KrisKasprzak/IrrigationGenie/AerialHouseView.png

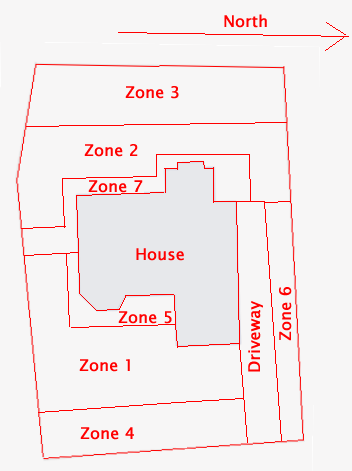
AerialHouseView.png
