KrisKasprzak/IrrigationGenie/docs/screenshots/tft-keyboard.png

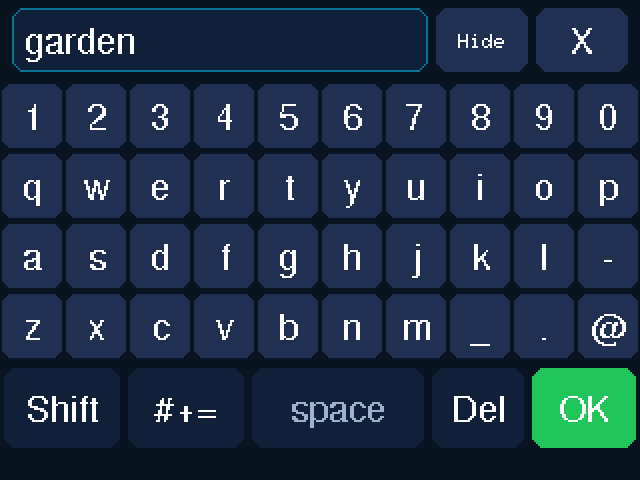
docs/screenshots/tft-keyboard.png
