KrisKasprzak/IrrigationGenie/docs/screenshots/tft-time-popup.png

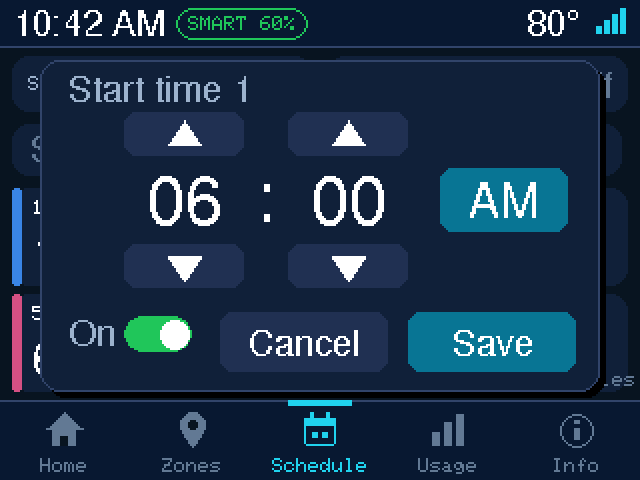
docs/screenshots/tft-time-popup.png
