KrisKasprzak/IrrigationGenie/docs/screenshots/tft-winter-popup.png

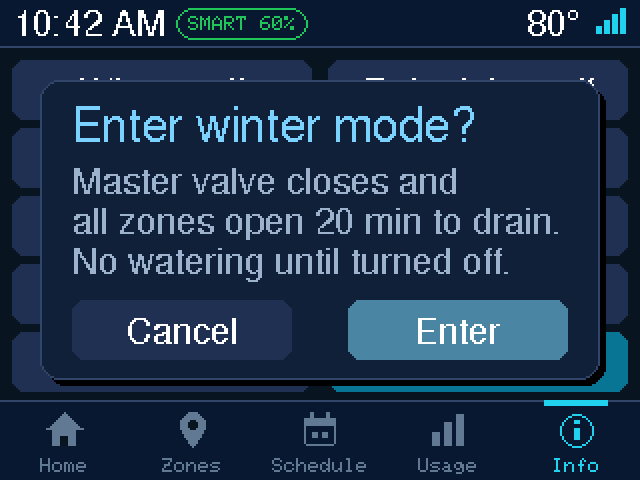
docs/screenshots/tft-winter-popup.png
