KrisKasprzak/IrrigationGenie/tools/preview.png

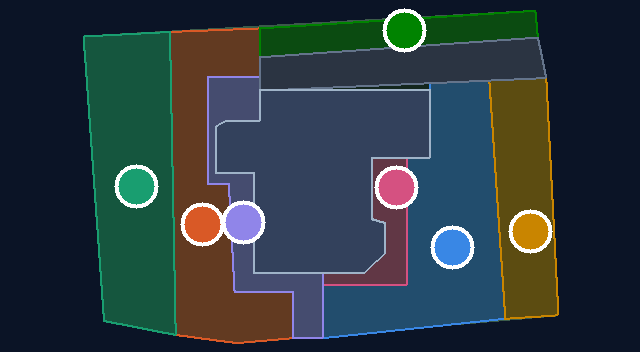
tools/preview.png
