KrisKasprzak/IrrigationGenie/hardware/IrrigationGenie_BOM.csv

ID | Name | Designator | Footprint | Quantity | Manufacturer Part | Manufacturer | Supplier | Supplier Part | Price
1 | ESP32-DEVKIT-V1-30PIN NORMALIZED COPY | 1 | ESP32-DEVKITV1_ESP32-DEVKITV1 | 1
2 | 24 VAC IN | 24VAC | TERMINALBLOCK:TERMINALBLOCK_MAIXU_MX126-5.0-02P_1X02_P5.00MM | 1
3 | 330 uF | C2 | CAP-D5.0XF2.0 | 1 | electrolytic capacitor 10UF 50V high frequency | ValuePro | LCSC | C78759 | 0.02
4 | 0.1 uF | C3 | CAP-TH_L6.5-W4.0-P5.00-D1.0 | 1 | Capacitor15nf100v | ReliaPro | LCSC | C26191
5 | 10 uF | C4 | CAP-D5.0XF2.0 | 1 | electrolytic capacitor 10UF 50V high frequency | ValuePro | LCSC | C78759 | 0.02
6 | 1A/40V | D1,D2,D3,D4,D5,D6,D7,D8 | DO35-7 | 8
7 | TERMINAL BLOCK | MASTER,ZONE_1,ZONE_2,ZONE_3,ZONE_4,ZONE_5,ZONE_6,ZONE_7 | TERMINALBLOCK:TERMINALBLOCK_MAIXU_MX126-5.0-02P_1X02_P5.00MM | 8
8 | 2N2222A | Q1,Q2,Q3,Q4,Q5,Q6,Q7,Q8,Q9 | TO-92-3_L4.8-W3.7-P2.54-R | 9 | 2N2222A | BLUE ROCKET(蓝箭) | LCSC | C358533 | 0.031
9 | 2N3906-TA | Q11 | TO-92-3_L4.8-W3.7-P2.54-L | 1 | 2N3906-TA | CJ(江苏长电/长晶) | LCSC | C19267730 | 0.031
10 | 1K0 | R1,R2,R3,R4,R5,R6,R7,R8,R9,R10 | AXIAL - CFR-25 | 10 | Resistor CFR-25 1/4 Watt
11 | BUZZER | SG1 | BUZZER | 1
12 | 240x320_2.8_TFT_TOUCH_SD | U1 | 240X320_2.8_TFT_TOUCH_SD | 1
13 | RELAY_MASTER | U2 | RELAY-TH_RELAY-SPST | 1 | Relay-SPST | null | LCSC | C2941249
14 | RELAY_ZONE_1 | U4 | RELAY-TH_RELAY-SPST | 1 | Relay-SPST | null | LCSC | C2941249
15 | RELAY_ZONE_2 | U5 | RELAY-TH_RELAY-SPST | 1 | Relay-SPST | null | LCSC | C2941249
16 | RELAY_ZONE_3 | U6 | RELAY-TH_RELAY-SPST | 1 | Relay-SPST | null | LCSC | C2941249
17 | RELAY_ZONE_4 | U7 | RELAY-TH_RELAY-SPST | 1 | Relay-SPST | null | LCSC | C2941249
18 | RELAY_ZONE_5 | U8 | RELAY-TH_RELAY-SPST | 1 | Relay-SPST | null | LCSC | C2941249
19 | RELAY_ZONE_6 | U9 | RELAY-TH_RELAY-SPST | 1 | Relay-SPST | null | LCSC | C2941249
20 | 3V3 | U10 | CA-1235 | 1
21 | FUSE 2A SLOW BLOW | U11 | FUSE_MINI | 1
22 | 5V0 | U12 | CA-1235 | 1
23 | Delinx 110 AC to DC Buck Converter | U13 | DELINX ACDC BUCK CONVERTER | 1 | B07SJRX9R6 | Delinx | Amazon | B07SJRX9R6
24 | RELAY_ZONE_7 | U14 | RELAY-TH_RELAY-SPST | 1 | Relay-SPST | null | LCSC | C2941249
