KrisKasprzak/IrrigationGenie/(commit log)

2026-10-31 Initial commit: IrrigationGenie smart irrigation controller
    ESP32 + 2.8" ILI9341 touch screen controller for 7 zones and a master
    valve, with manual, day-of-week schedule and weather-adjusted smart
    watering (Open-Meteo ET0 and rain forecast), winter drain mode, 30-day
    usage tracking, a yard map, and a phone web app served from the ESP32.
    Includes README with wiring and setup, screenshots rendered from the
    firmware and phone app, and the tools that generate them.
2026-10-31 Add wiring schematic, match relay polarity to the transistor drivers
    - README: new Wiring section with the full schematic at column width,
    hardware list updated to the actual board (fused 24 VAC supply,
    3.3 V / 5 V buck converters, 2N2222A relay drivers)
    - RELAY_ACTIVE_LOW false: each relay is driven by a 2N2222A, so pin
    HIGH = relay on; with true every valve would open at boot
2026-10-31 Move zones 6/7 to GPIO 12/13, add manual zone grid on home
    - Zone 6 -> GPIO 12, zone 7 -> GPIO 13 (16/17 now free, WROVER safe);
    pin comments note GPIO 12 is a strapping pin that must stay low at boot
    - Manual mode: home card shows all 7 zones + OFF; a tap opens the zone
    popup with a run time, for every zone whether or not it is scheduled
    - Updated wiring schematic, README pin table and screens, new
    tft-manual screenshot and overview
    - Relay test in setup kept commented out
2026-11-01 Update wiring schematic and add power notes to README
    Schematic: fix the AC/DC converter's DC output polarity into both
    CA-1235 converters, 2 A slow blow fuse, note to solder the TFT's J1
    jumper, and move the 24 VAC wire off D1.
    README: match the fuse and power supply description, and add notes on
    the TFT J1 jumper, powering the ESP32 through 3V3 vs USB, converter
    polarity and fuse sizing.
2026-11-01 Add parts list (BOM)
    [IrrigationGenie_BOM.csv]
2026-11-01 Switch license from MIT to PolyForm Noncommercial 1.0.0
    Free for noncommercial use, provided as is without warranty.
2026-11-01 Smart mode rain skips, remove video placeholder code
    - Skip when the day's chance of rain is above popSkip (default 5%)
    - Skip after rainDays rain days in a row (default 3), weather now fetches 3 past days
    - Both thresholds adjustable in the phone app
    - Remove the temporary DEMO_INFO placeholders
    [Config.h, IrrigationGenie.ino, Net.ino, Storage.ino, Valves.ino]
