KrisKasprzak/IrrigationGenie/(notices)

Notices in the files:
IrrigationGenie/IrrigationGenie.ino:
License: PolyForm Noncommercial 1.0.0 (see LICENSE). Free for noncommercial use only.
